JenertsA/multi-level-soil-probe/hardware/temp_sensor_ring_pcb/PCB_render_top.PNG

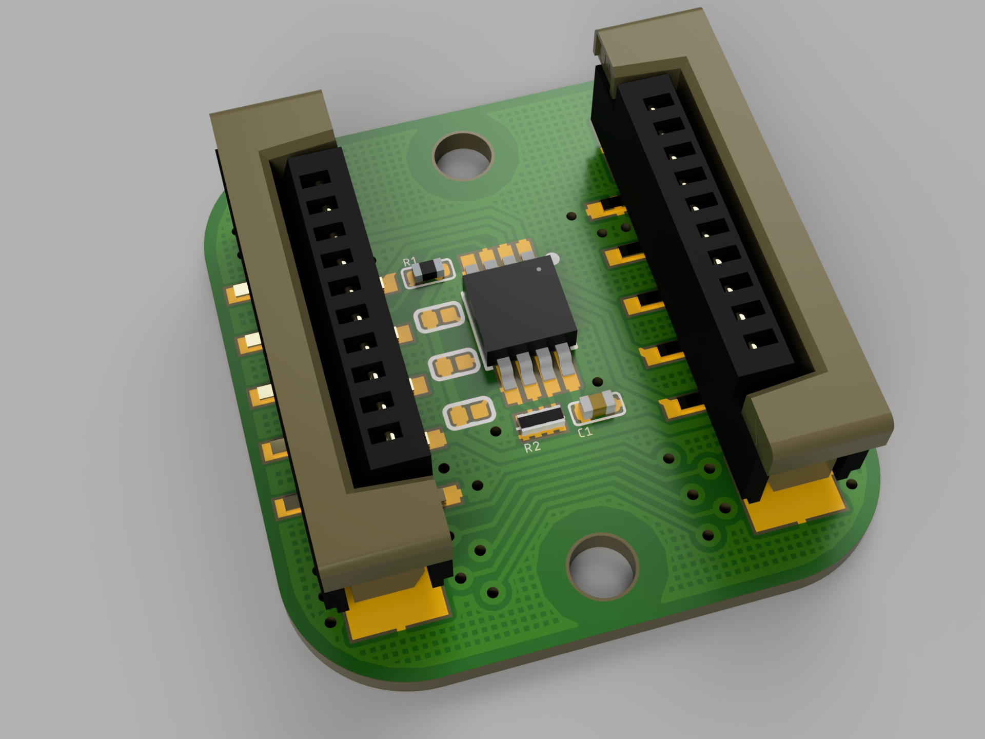
hardware/temp_sensor_ring_pcb/PCB_render_top.PNG
