JenertsA/multi-level-soil-probe/hardware/temp_sensor_ring_pcb/PCB_render_bottom.png

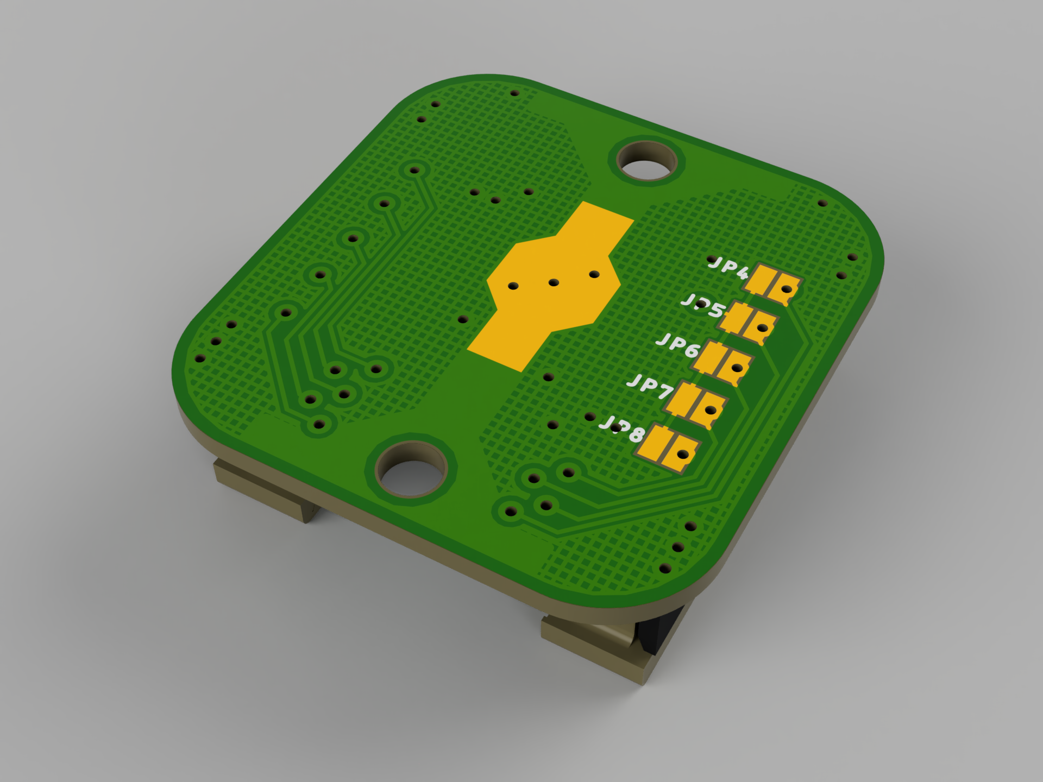
hardware/temp_sensor_ring_pcb/PCB_render_bottom.png
