JenertsA/multi-level-soil-probe/README.md

# multi-level-soil-probe
Design files and firmware for multi level soil probe with LoRa connectivity
