JenertsA/multi-level-soil-probe/hardware/temp_sensor_ring_pcb/CAM/FRAME/FRAME_artlayer.gbo_artwork.png

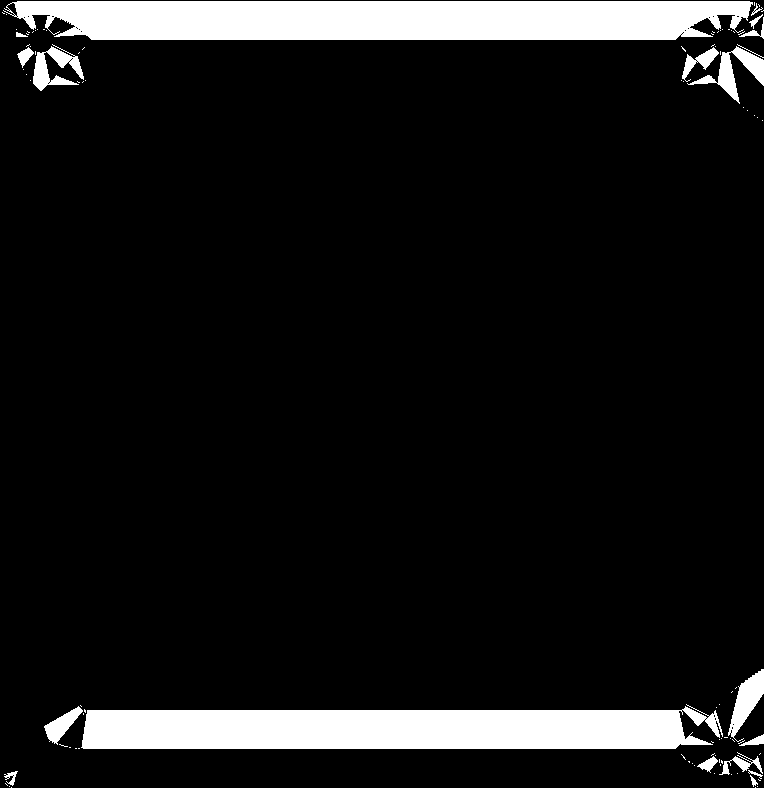
hardware/temp_sensor_ring_pcb/CAM/FRAME/FRAME_artlayer.gbo_artwork.png
