JenertsA/multi-level-soil-probe/hardware/temp_sensor_ring_pcb/CAM/FRAME/FRAME_artlayer.gbo_renderAngle.png

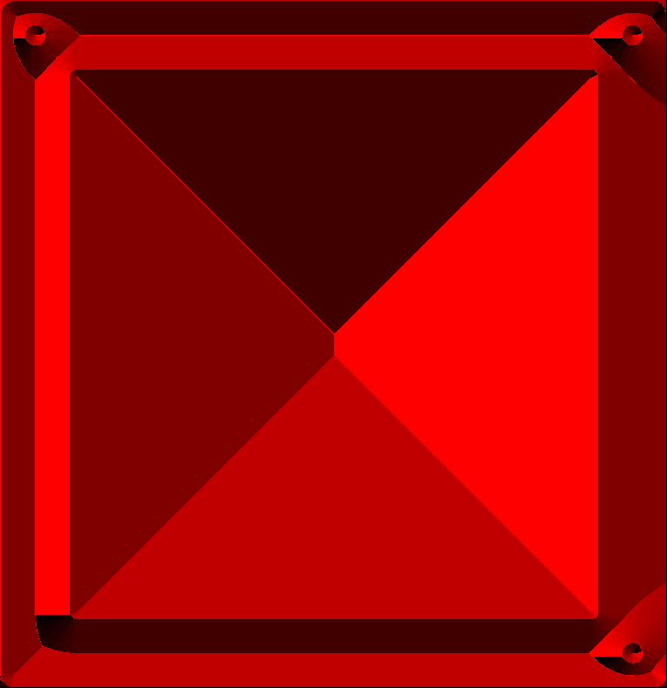
hardware/temp_sensor_ring_pcb/CAM/FRAME/FRAME_artlayer.gbo_renderAngle.png
