JenertsA/multi-level-soil-probe/hardware/temp_sensor_ring_pcb/CAM/FRAME/FRAME_artlayer.gto_renderbase.png

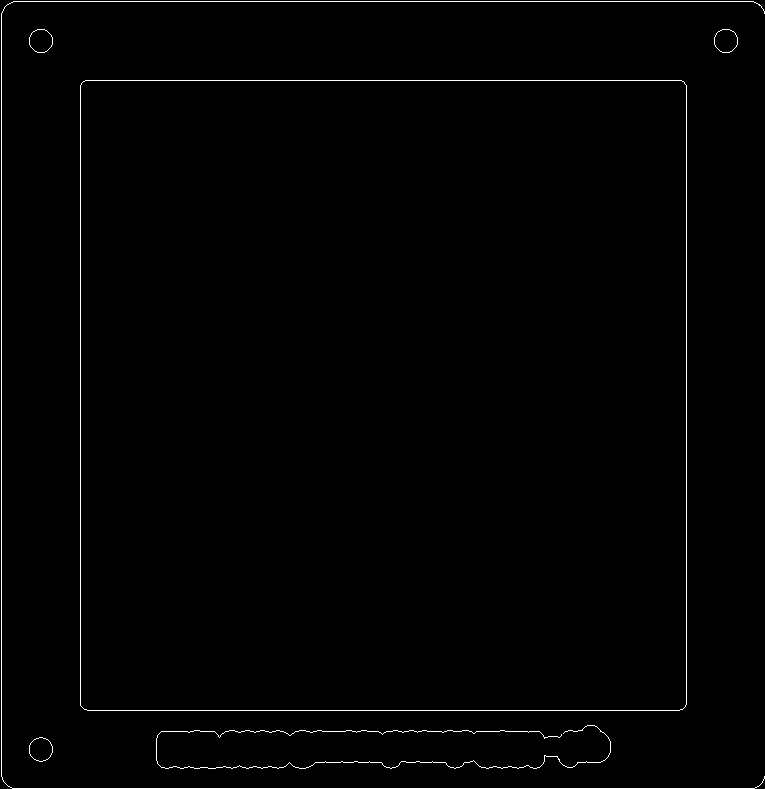
hardware/temp_sensor_ring_pcb/CAM/FRAME/FRAME_artlayer.gto_renderbase.png
