JenertsA/multi-level-soil-probe/hardware/temp_sensor_ring_pcb/CAM/FRAME/FRAME_bottom_XRAY.png

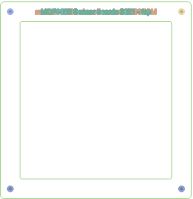
hardware/temp_sensor_ring_pcb/CAM/FRAME/FRAME_bottom_XRAY.png
