JenertsA/multi-level-soil-probe/hardware/temp_sensor_ring_pcb/CAM/FRAME/FRAME_Combined_Bottom.png

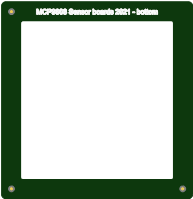
hardware/temp_sensor_ring_pcb/CAM/FRAME/FRAME_Combined_Bottom.png
