JenertsA/multi-level-soil-probe/hardware/temp_sensor_ring_pcb/CAM/FRAME/FRAME_top_XRAY.png

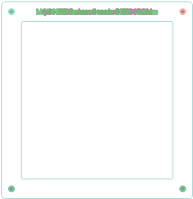
hardware/temp_sensor_ring_pcb/CAM/FRAME/FRAME_top_XRAY.png
