JenertsA/multi-level-soil-probe/hardware/single_ring_assy_drawing.pdf

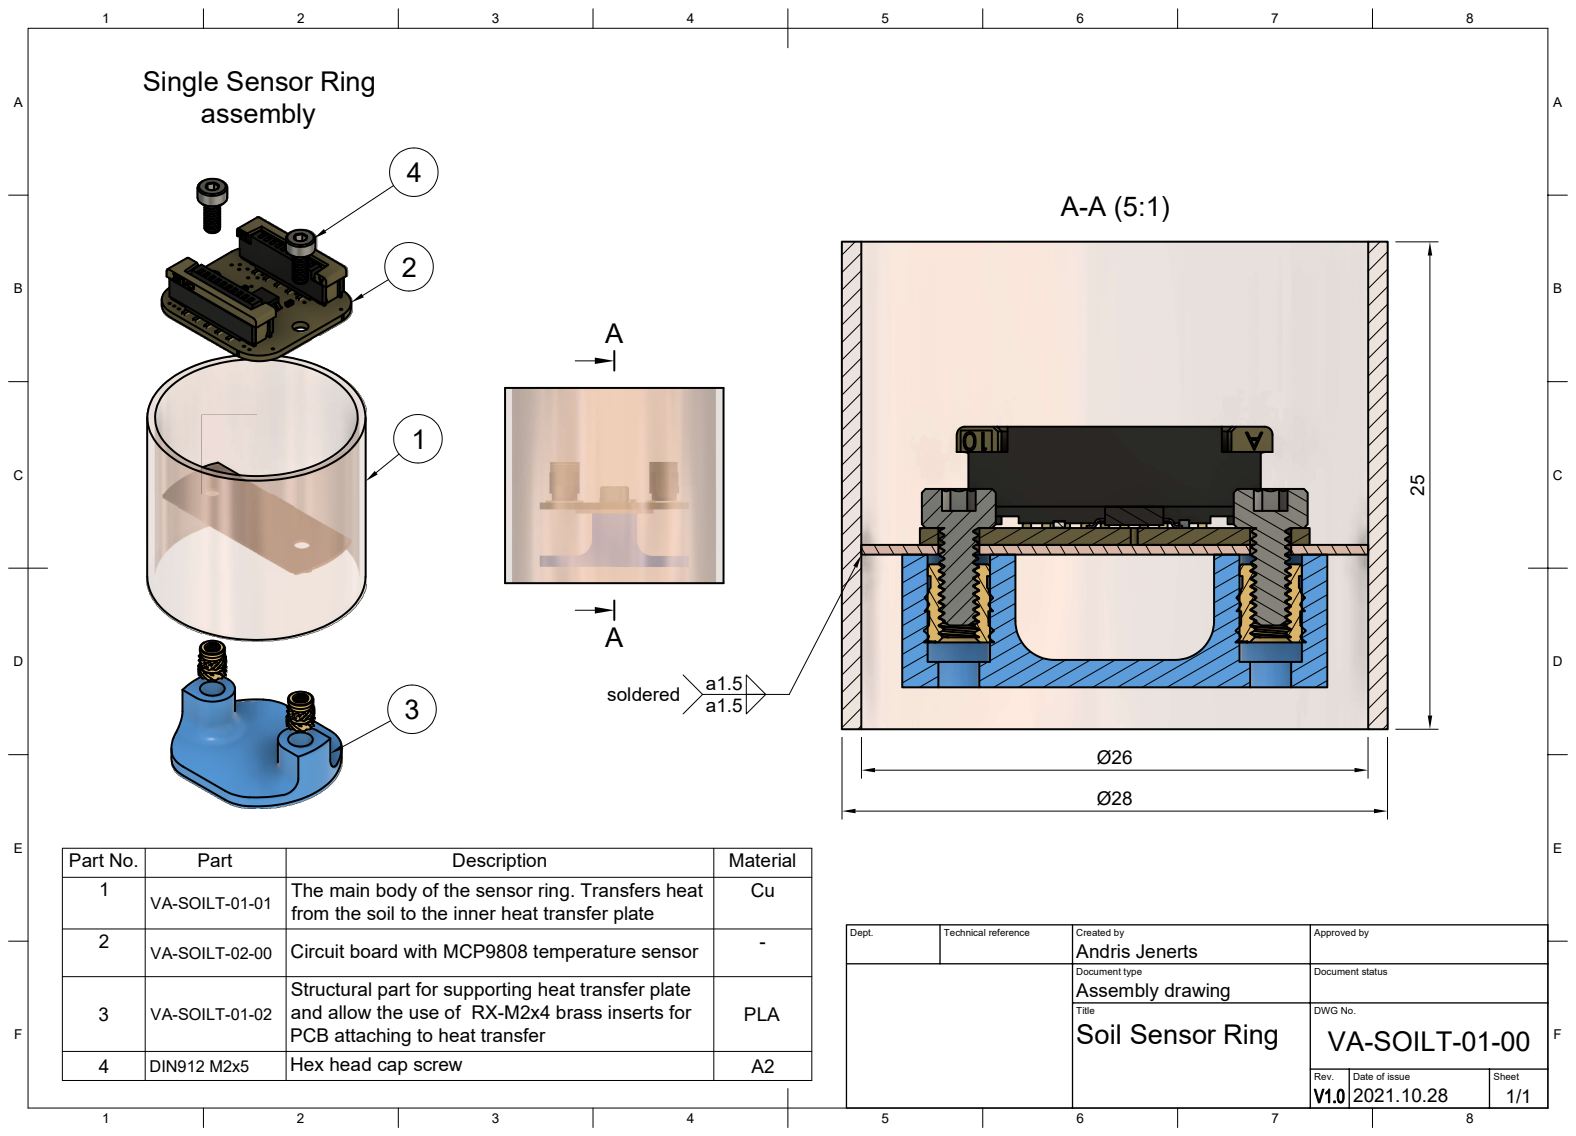
[picture p11: page 1]
8 BCDEF; ABCDEF Dept.; Technical reference; Created by; Approved by Document type; Document status Title; DWG No. Rev.; Date of issue; Sheet 2021.10.28 Assembly drawing; 1/1 Soil Sensor Ring; VA-SOILT-01-00 Andris Jenerts Single Sensor Ring assembly

25 23 4 DIN912 M2x5 Hex head cap screw A2 3 VA-SOILT-01-02 Structural part for supporting heat transfer plate and allow the use of RX-M2x4 brass inserts for PCB attaching to heat transfer PLA 2 VA-SOILT-02-00 Circuit board with MCP9808 temperature sensor - 1 VA-SOILT-01-01 The main body of the sensor ring. Transfers heat from the soil to the inner heat transfer plate Cu Part No. Part Description Material a1.5 a1.5 soldered 14
