JenertsA/multi-level-soil-probe/hardware/RAK3172_board/RAK3172_board.brd

## EAGLE design hardware/RAK3172_board/RAK3172_board.brd (2022-01-08)

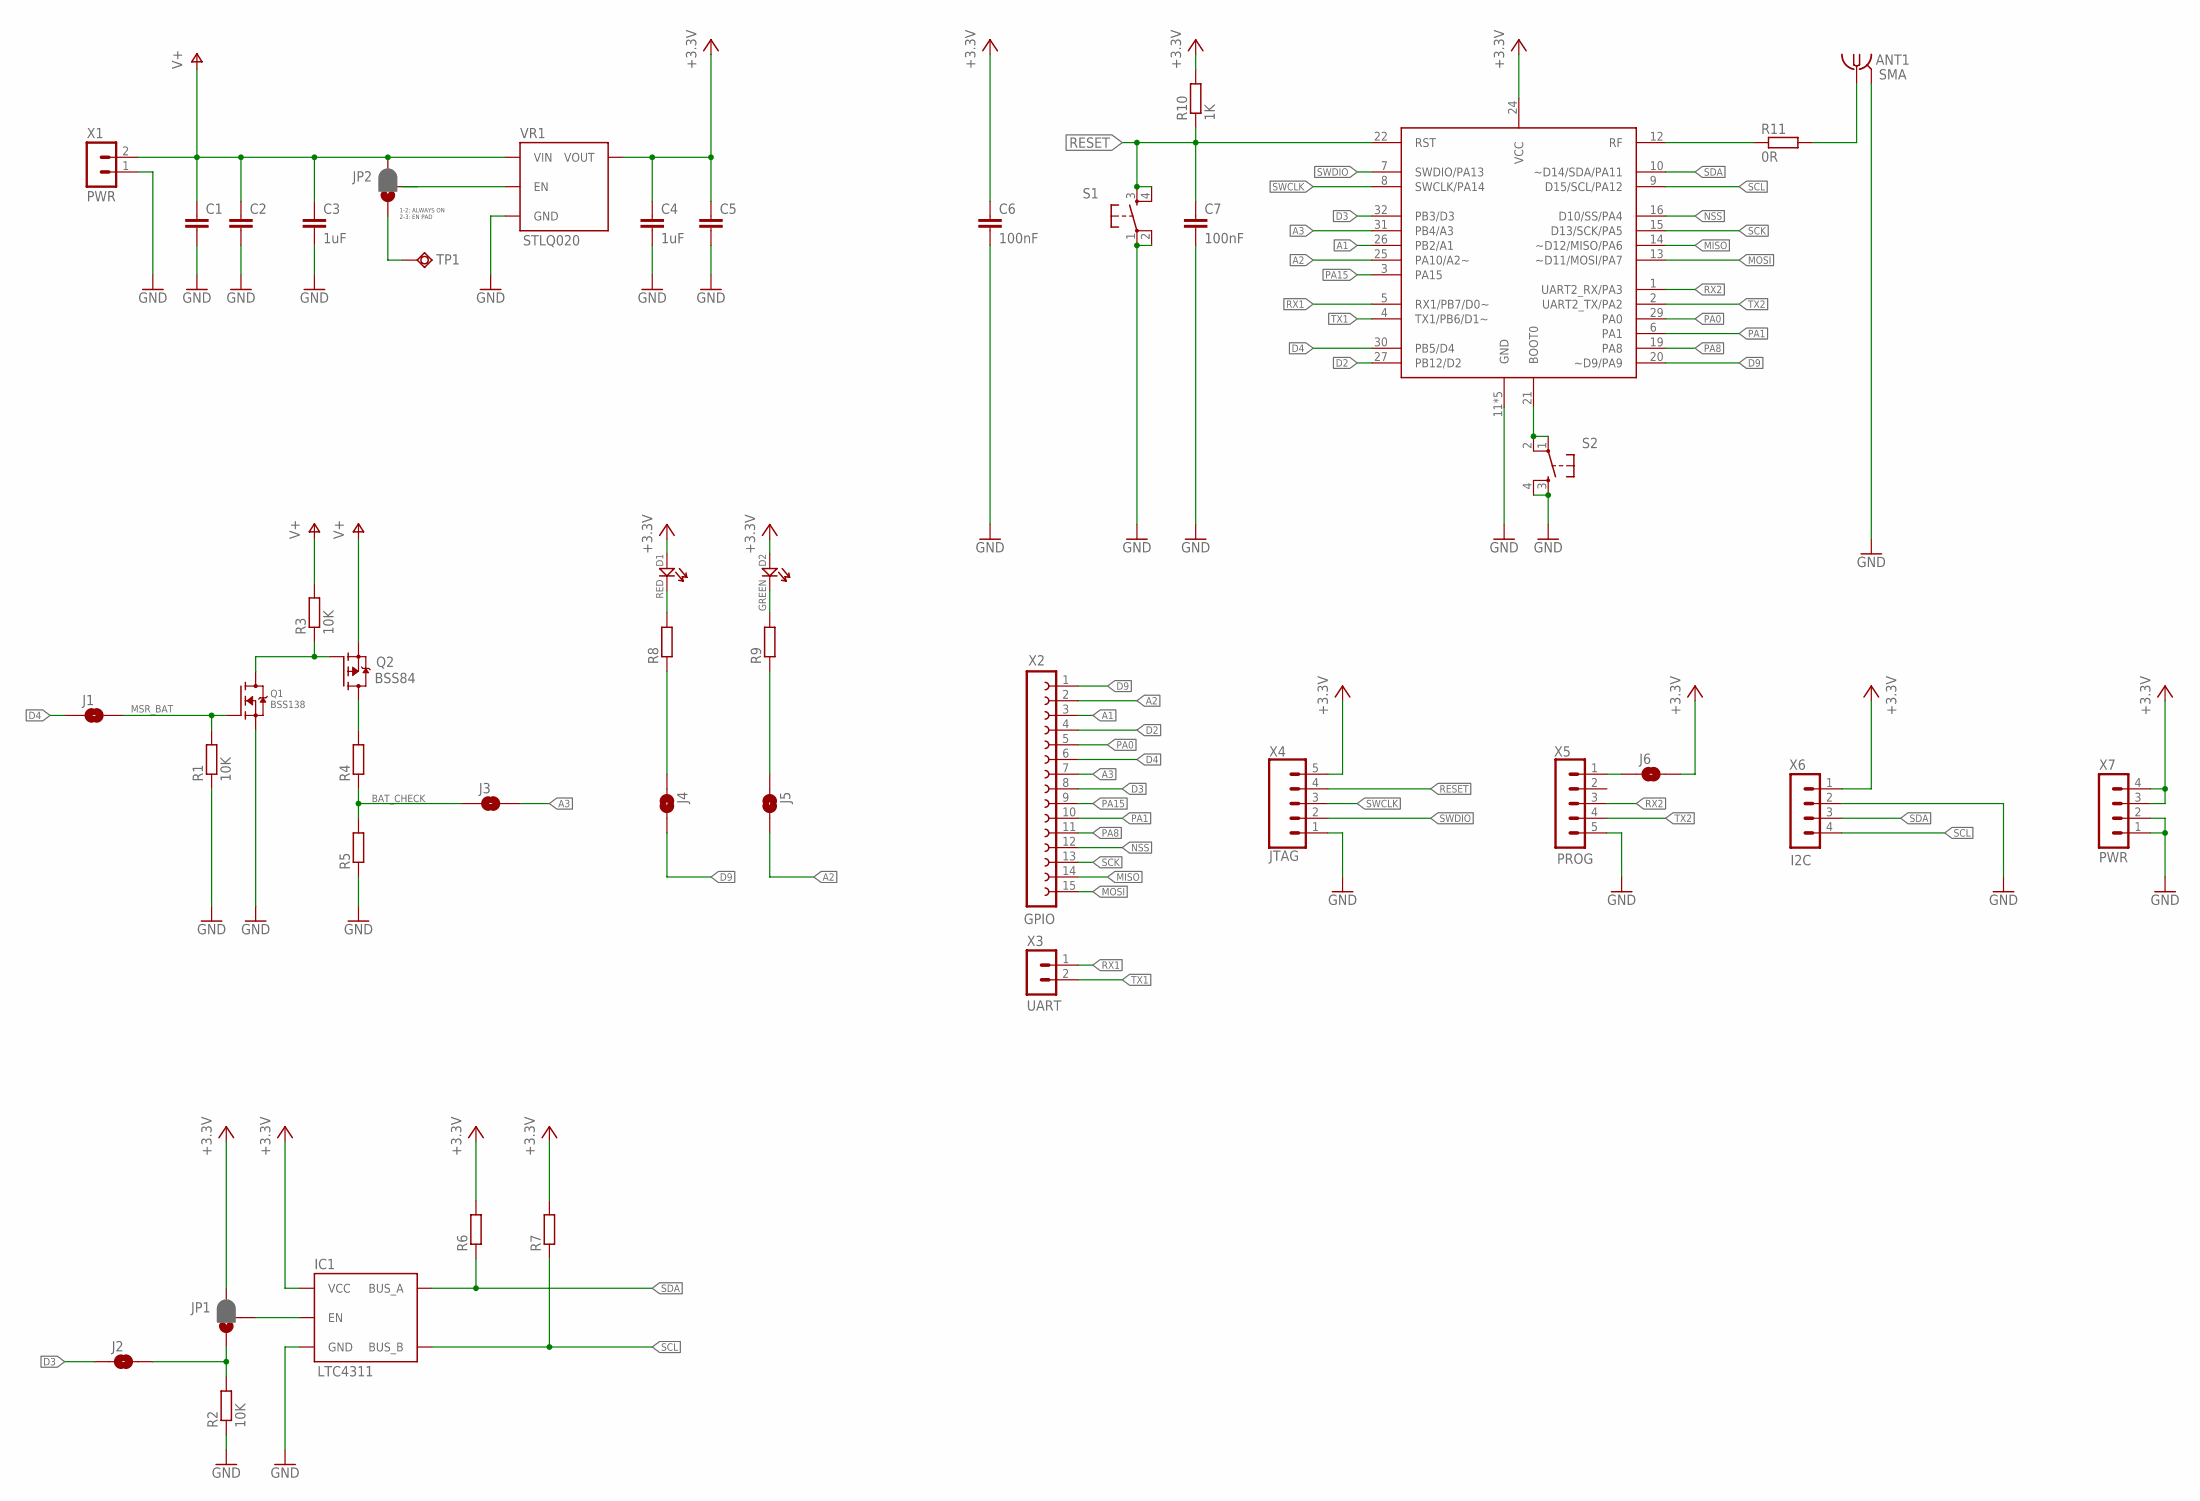
[picture p12: schematic RAK3172_board.sch]

Parts:
ANT1: SMA; SMA_1MM
C1, C2, C5: CAP_CERAMIC_0603; SMD_0603C
C3, C4: 1uF; SMD_0603C
C6, C7: 100nF; SMD_0603C
D1: RED; LED-0805
D2: GREEN; LED-0805
IC1: LTC4311; SC-70-6
IC2: RAK3172HF; RAK3172
J1, J2, J3, J4, J5, J6: SMD_JUMP_2_NO_N; SMT_JUMP_2_NO
JP1, JP2: JUMPER-SMT_3_1-NC_PASTE_SILK; SMT-JUMPER_3_1-NC_PASTE_SILK
Q1: BSS138; SOT-23-3
Q2: BSS84; SOT-23-3
R1, R2, R3: 10K; SMD_0603
R4, R5, R6, R7, R8, R9: RESISTOR_0603; SMD_0603
R10: 1K; SMD_0603
R11: 0R; SMD_0603
S1, S2: BTNRKB2; RKB2
TP1: PAD1.5X3.0
VR1: STLQ020; SOT323-5L
X1: PWR; JST-PH_2
X2: GPIO; 1X15
X3: UART; 1X02
X4: JTAG; 1X05_LOCK
X5: PROG; JST05_2MM
X6: I2C; JST-PH_4
X7: PWR; 2X02

Connections:
+3V3: C4.1, C5.1, C6.1, D1.+, D2.+, IC1.P1 (VCC), IC2.24 (VCC), J6.2, JP1.3, R6.2, R7.2, R10.2, VR1.P$5 (VOUT), X4.5, X6.1, X7.3, X7.4
A1: IC2.26 (PB2/A1), X2.3
A2: IC2.25 (PA10/A2~), J5.2, X2.2
A3: IC2.31 (PB4/A3), J3.2, X2.7
AS: J4.1, R8.1
BAT_CHECK: J3.1, R4.1, R5.2
D2: IC2.27 (PB12/D2), X2.4
D3: IC2.32 (PB3/D3), J2.1, X2.8
D4: IC2.30 (PB5/D4), J1.1, X2.6
D9: IC2.20 (~D9/PA9), J4.2, X2.1
GND/2: ANT1.G@1 (GND), ANT1.G@2 (GND), ANT1.G@3 (GND), ANT1.G@4 (GND), C1.2, C2.2, C3.2, C4.2, C5.2, C6.2, C7.2, IC1.P2 (GND), IC1.P5 (GND), IC2.11 (GND), IC2.17 (GND), IC2.18 (GND), IC2.23 (GND), IC2.28 (GND), Q1.2 (S), R1.1, R2.1, R5.1, S1.1, S1.2 (P1), S2.3 (S), S2.4 (S1), VR1.P$2 (GND), X1.1, X4.1, X5.5, X6.2, X7.1, X7.2
MISO: IC2.14 (~D12/MISO/PA6), X2.14
MOSI: IC2.13 (~D11/MOSI/PA7), X2.15
MSR_BAT: J1.2, Q1.1 (G), R1.2
unnamed: IC2.12 (RF), R11.1
unnamed: IC2.21 (BOOT0), S2.1, S2.2 (P1)
unnamed: ANT1.1, R11.2
unnamed: J6.1, X5.1
unnamed: JP2.2, VR1.P$3 (EN)
unnamed: JP2.1, TP1.P$1
unnamed: Q1.3 (D), Q2.1 (G), R3.1
unnamed: D1.-, R8.2
unnamed: J2.2, JP1.1, R2.2
unnamed: D2.-, R9.2
unnamed: Q2.3 (D), R4.2
unnamed: IC1.P3 (EN), JP1.2
NSS: IC2.16 (D10/SS/PA4), X2.12
PA0: IC2.29 (PA0), X2.5
PA1: IC2.6 (PA1), X2.10
PA8: IC2.19 (PA8), X2.11
PA15: IC2.3 (PA15), X2.9
QGWEG: J5.1, R9.1
RESET: C7.1, IC2.22 (RST), R10.1, S1.3 (S), S1.4 (S1), X4.4
RX1: IC2.5 (RX1/PB7/D0~), X3.1
RX2: IC2.1 (UART2_RX/PA3), X5.3
SCK: IC2.15 (D13/SCK/PA5), X2.13
SCL: IC1.P6 (BUS_B), IC2.9 (D15/SCL/PA12), R7.1, X6.4
SDA: IC1.P4 (BUS_A), IC2.10 (~D14/SDA/PA11), R6.1, X6.3
SWCLK: IC2.8 (SWCLK/PA14), X4.3
SWDIO: IC2.7 (SWDIO/PA13), X4.2
TX1: IC2.4 (TX1/PB6/D1~), X3.2
TX2: IC2.2 (UART2_TX/PA2), X5.4
V+: C1.1, C2.1, C3.1, JP2.3, Q2.2 (S), R3.2, VR1.P$1 (VIN), X1.2

Notes on the sheet:
1-2: ALWAYS ON 2-3: EN PAD

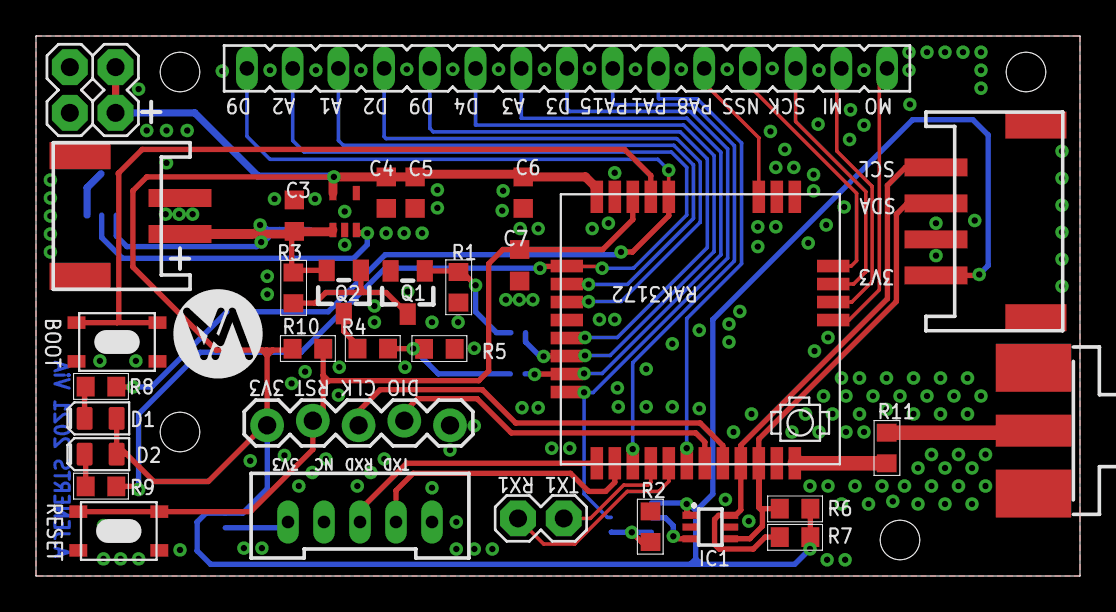
[picture p13: board RAK3172_board.brd from above]

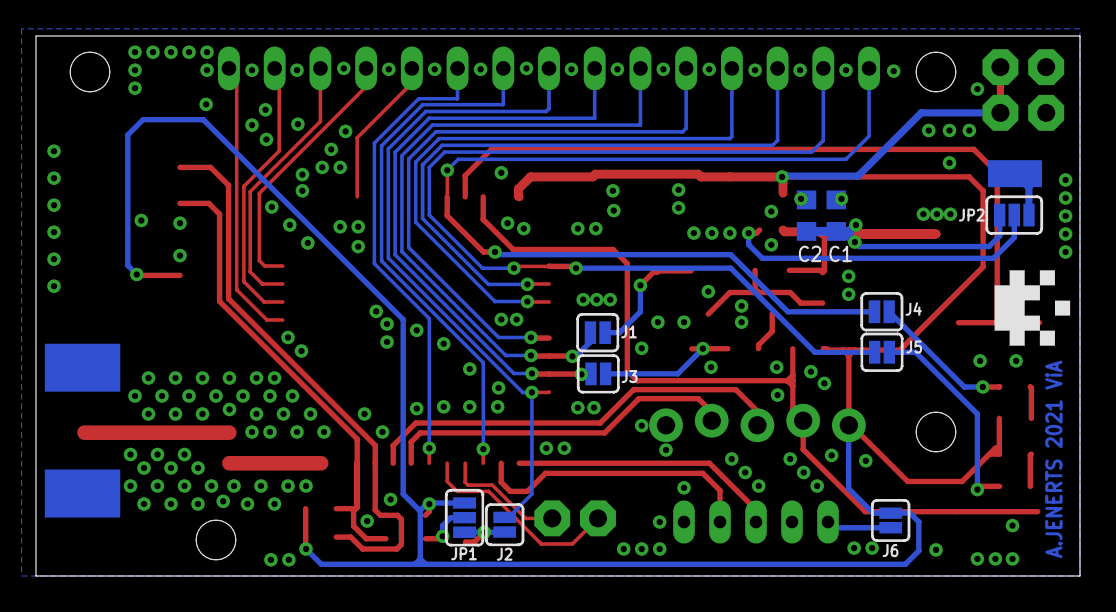
[picture p14: board RAK3172_board.brd from below]

Board: 2 copper layers, 58.0 x 30.0 mm, 45 parts (12 on the bottom side), 43 nets.

Other parts of the board:
U$3: A.JENERTS_5MM
