JenertsA/multi-level-soil-probe/hardware/temp_sensor_ring_pcb/temp_sens_ring.brd

## EAGLE design hardware/temp_sensor_ring_pcb/temp_sens_ring.brd (2022-01-08)

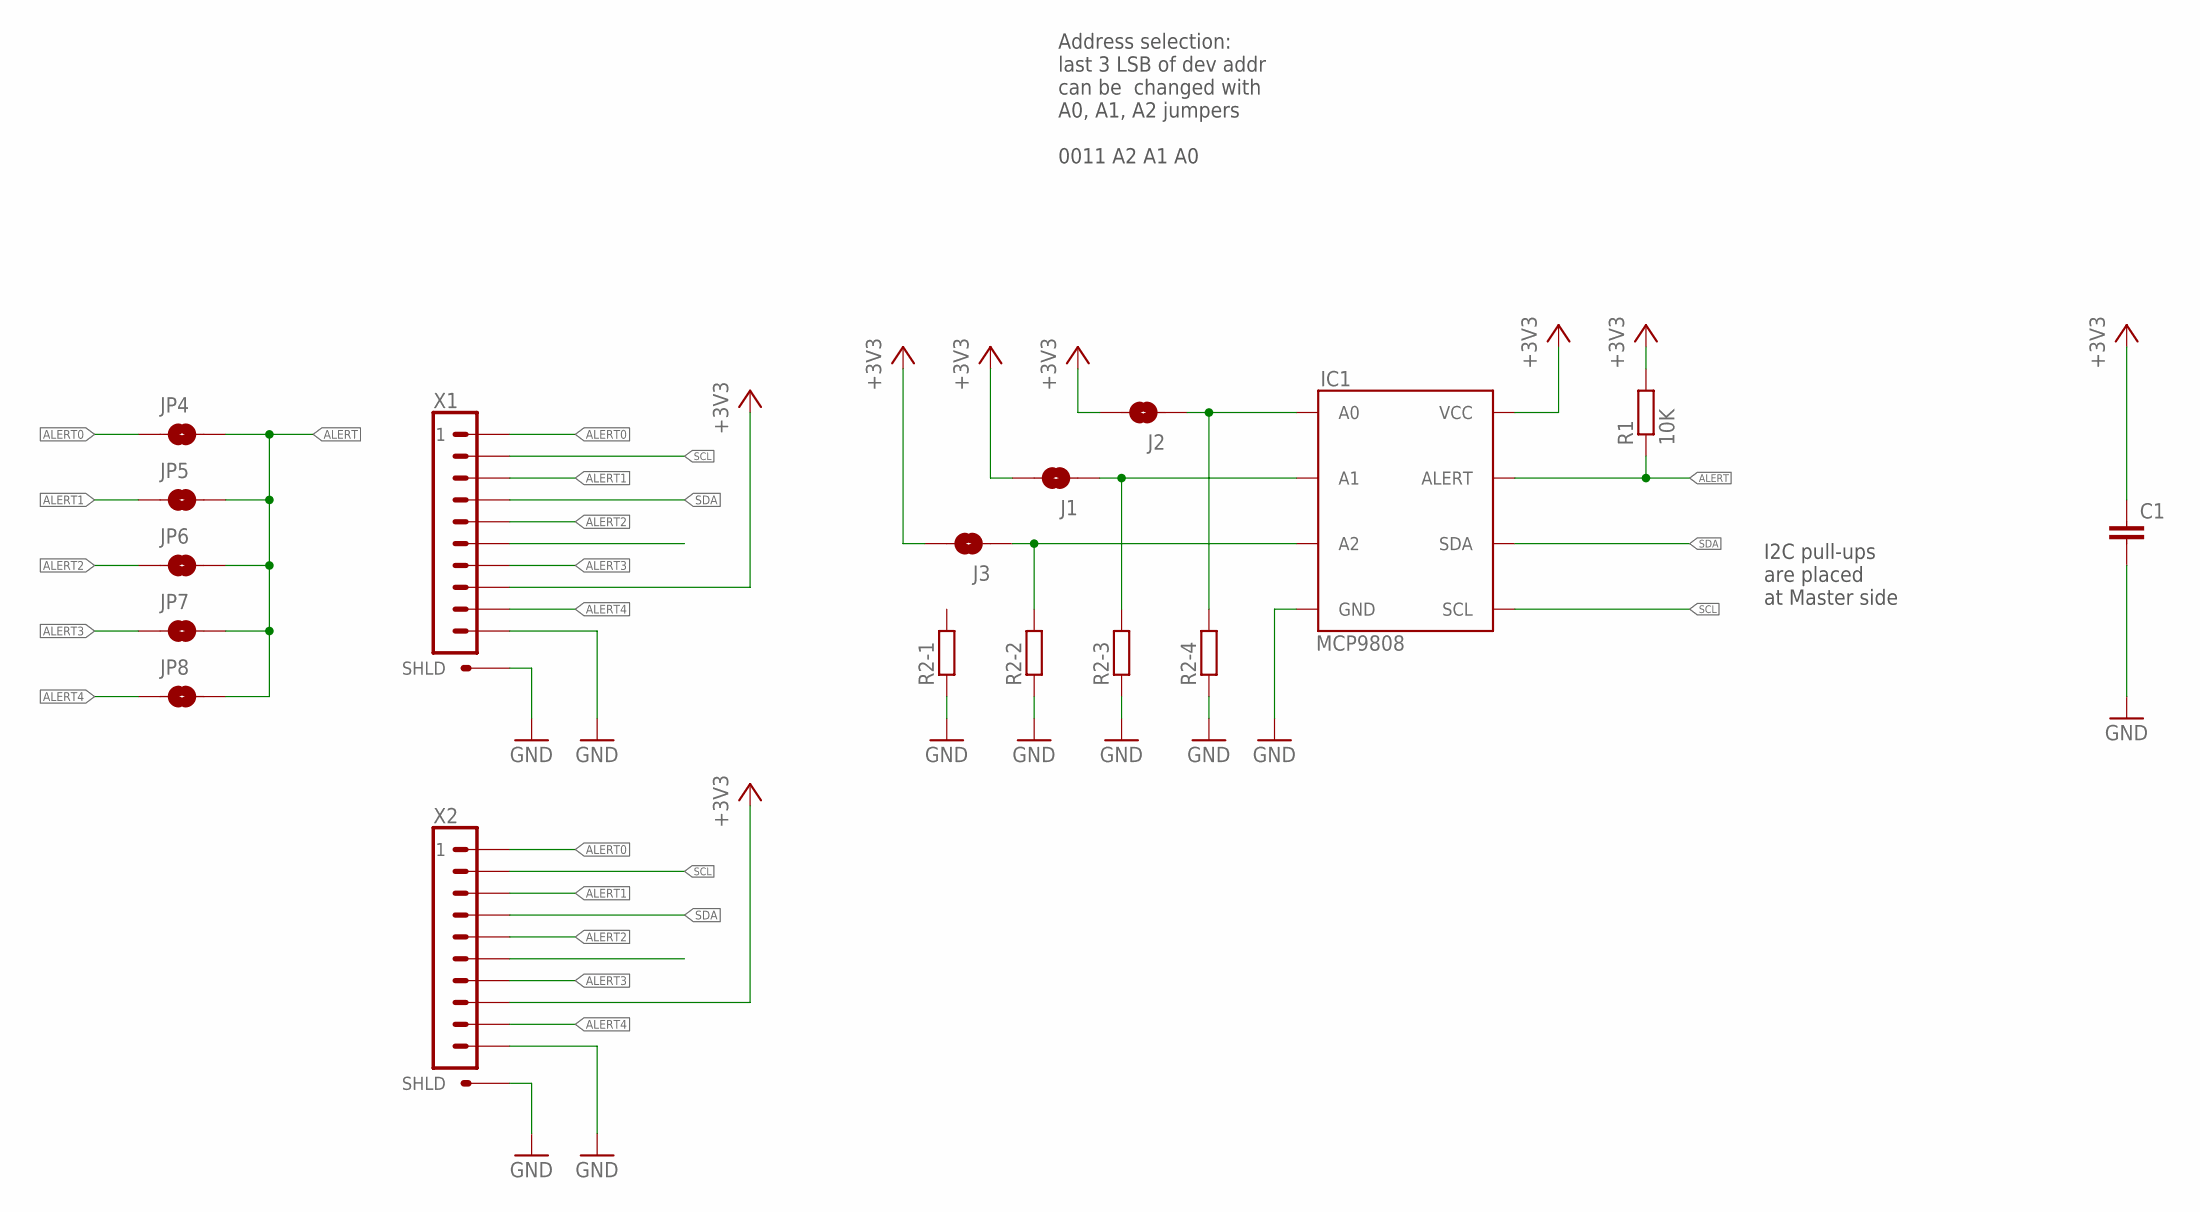
[picture p15: schematic temp_sens_ring.sch]

Parts:
C1: CAP_CERAMIC_0402; C0402
IC1: MCP9808; MSOP-8
J1, J2, J3: SMD_JUMP_2_NO_S; SMT_JUMP_2_NO_SMALL
JP4: AL0; SMT-JUMPER_2_NO_NO-SILK
JP5: AL1; SMT-JUMPER_2_NO_NO-SILK
JP6: AL2; SMT-JUMPER_2_NO_NO-SILK
JP7: AL3; SMT-JUMPER_2_NO_NO-SILK
JP8: AL4; SMT-JUMPER_2_NO_NO-SILK
R1: 10K; 0402
R2: RESISTOR_NET_4-0502; R0502_4X
X1, X2: FFC_10PV; FFC_1X10_VERTICAL; MFR_PART F1002-B-10-20T-R

Connections:
+3V3: C1.1, IC1.P$8 (VCC), J1.2, J2.2, J3.2, R1.2, X1.P$8 (8), X2.P$8 (8)
ALERT: IC1.P$3 (ALERT), JP4.2, JP5.2, JP6.2, JP7.2, JP8.2, R1.1
ALERT0: JP4.1, X1.P$1 (1), X2.P$1 (1)
ALERT1: JP5.1, X1.P$3 (3), X2.P$3 (3)
ALERT2: JP6.1, X1.P$5 (5), X2.P$5 (5)
ALERT3: JP7.1, X1.P$7 (7), X2.P$7 (7)
ALERT4: JP8.1, X1.P$9 (9), X2.P$9 (9)
GND: C1.2, IC1.P$4 (GND), R2.P$1 (1), R2.P$2 (1), R2.P$3 (1), R2.P$4 (1), X1.P$10 (10), X1.P$11 (SHLD), X1.P$12 (SHLD), X2.P$10 (10), X2.P$11 (SHLD), X2.P$12 (SHLD)
unnamed: IC1.P$5 (A2), J3.1, R2.P$7 (2)
unnamed: IC1.P$6 (A1), J1.1, R2.P$6 (2)
unnamed: IC1.P$7 (A0), J2.1, R2.P$5 (2)
SCL: IC1.P$2 (SCL), X1.P$2 (2), X2.P$2 (2)
SDA: IC1.P$1 (SDA), X1.P$4 (4), X2.P$4 (4)

Notes on the sheet:
Address selection: last 3 LSB of dev addr can be changed with A0, A1, A2 jumpers 0011 A2 A1 A0
I2C pull-ups are placed at Master side

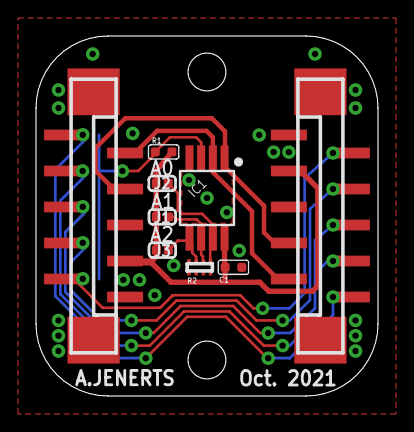
[picture p16: board temp_sens_ring.brd from above]

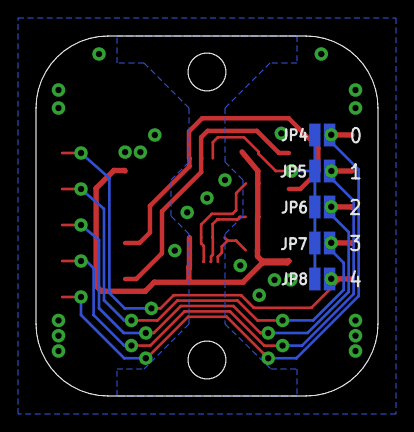
[picture p17: board temp_sens_ring.brd from below]

Board: 2 copper layers, 19.0 x 20.0 mm, 14 parts (5 on the bottom side), 13 nets.
