JenertsA/multi-level-soil-probe/hardware/i2c_header/I2C_header.brd

## EAGLE design hardware/i2c_header/I2C_header.brd (2022-01-08)

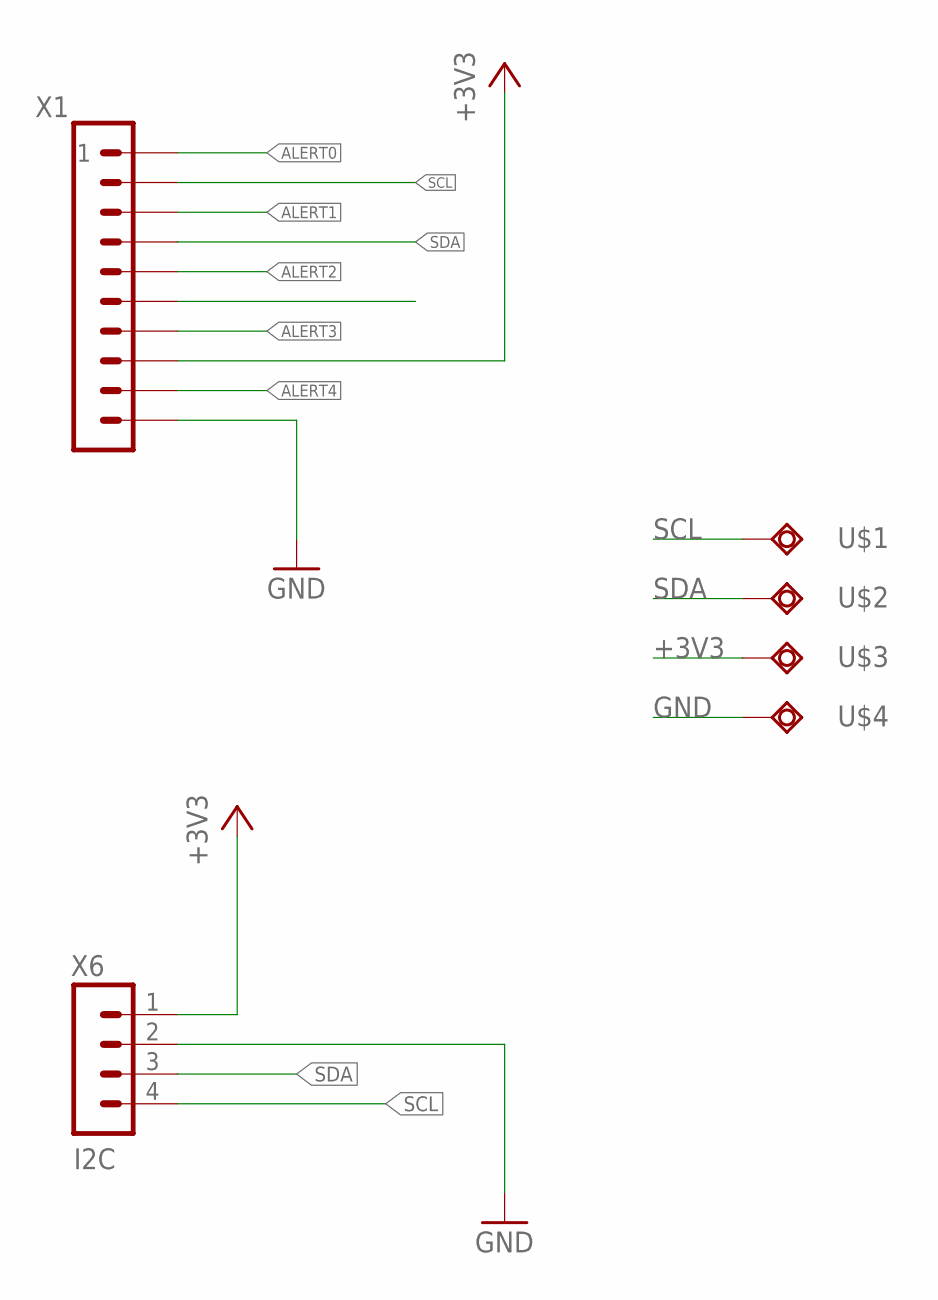
[picture p18: schematic I2C_header.sch]

Parts:
U$1, U$2, U$3, U$4: PAD3.0X5.0; PAD3X5
X1: FFC_10PLARGE; FFC_1.0X10_LARGE_PADS
X6: I2C; JST-PH_4

Connections:
+3V3: U$3.P$1, X1.P$8 (8), X6.1
ALERT0: X1.P$1 (1)
ALERT1: X1.P$3 (3)
ALERT2: X1.P$5 (5)
ALERT3: X1.P$7 (7)
ALERT4: X1.P$9 (9)
GND: U$4.P$1, X1.P$10 (10), X6.2
SCL: U$1.P$1, X1.P$2 (2), X6.4
SDA: U$2.P$1, X1.P$4 (4), X6.3

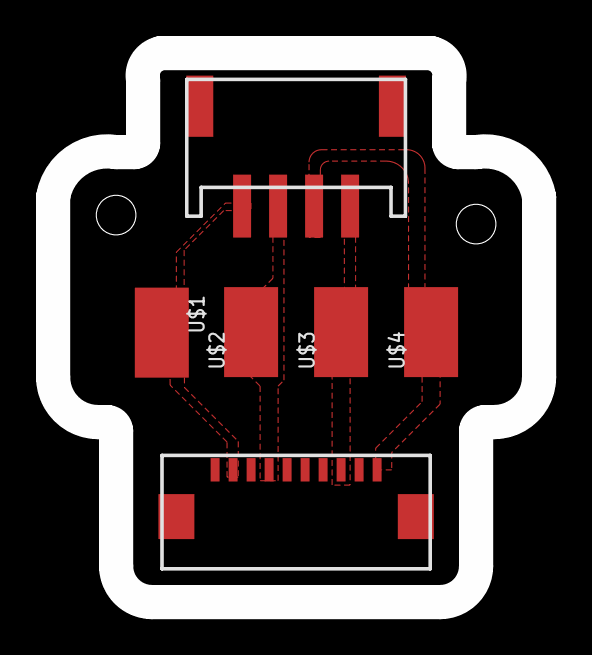
[picture p19: board I2C_header.brd from above]

Board: 2 copper layers, 27.0 x 30.5 mm, 6 parts (0 on the bottom side), 4 nets.
