JenertsA/multi-level-soil-probe/(commit log)

2021-10-21 Inital commit of sch
    [temp_sens_ring.sch]
2021-10-23 inital board commit
    [temp_sens_ring.brd, temp_sens_ring.sch]
2021-10-23 Screw holes added
    [temp_sens_ring.brd]
2021-10-27 PCB completed, part library created
    [temp_sens_ring.brd, temp_sens_ring.sch]
2021-10-27 3D models added to library
    [temp_sens_ring.brd, temp_sens_ring.sch]
2021-10-28 Mounting hole dimension updated for free fit M2
    [temp_sens_ring.brd]
2021-10-28 Single ring assembly drawing added
2021-10-28 folder name changed
    [temp_sens_ring.brd, temp_sens_ring.sch]
2022-01-08 I2C_header board added
    [I2C_header.brd, I2C_header.sch]
2022-01-08 Board dimension added
    [I2C_header.brd]
2022-01-08 PCB production done
    [RAK3172_board.brd, RAK3172_board.sch]
2022-01-08 temperature ring sensor CAM files
    [101_temp_sens_ring_20211212.GBL, 102_temp_sens_ring_20211212.GBO, 104_temp_sens_ring_20211212.GBS, 105_temp_sens_ring_20211212.GKO, 106_temp_sens_ring_20211212.GTL, 107_temp_sens_ring_20211212.GTO, 109_temp_sens_ring_20211212.GTS, 10_FRAME_artlayer.gbo]
